pepealessio/self-balancing-robot-stm32/README.md

# Self Balancing Robot STM32

A demostration video can be watched at https://youtu.be/qOr8XTu--TQ.

The documentation can be readed at .\doc\documentation_v1.0.

The esp32 code is in .\ESP32_code

The STM32 code is in .\STM32_code

The desktop application is in .\Desktop_Controller
