pepealessio/self-balancing-robot-stm32/Schemes/control scheme.jpg

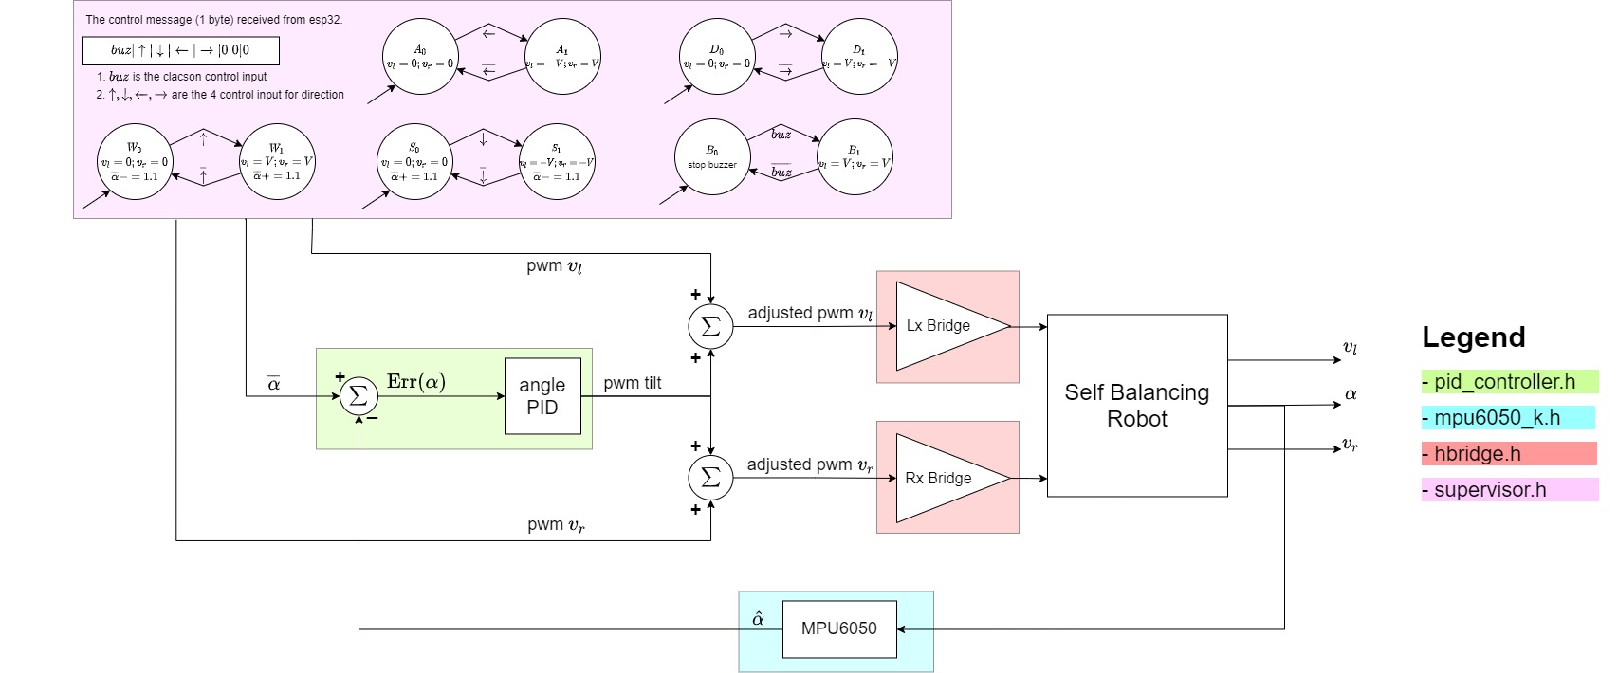
Schemes/control scheme.jpg
