pepealessio/self-balancing-robot-stm32/Schemes/SBR model.jpg

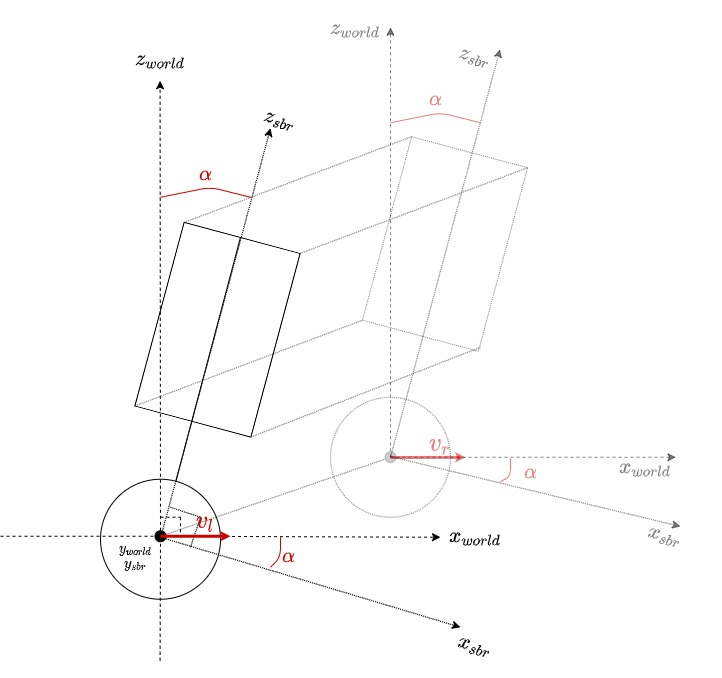
Schemes/SBR model.jpg
