pepealessio/self-balancing-robot-stm32/(list of files, drawings)

Other design files:
Schemes/sbr_v1.0.fzz
