pepealessio/self-balancing-robot-stm32/STM32_code/mcu6050_angle/Core/Src/main.c

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
/* Includes ------------------------------------------------------------------*/
#include "main.h"
#include "i2c.h"
#include "tim.h"
#include "usart.h"
#include "gpio.h"

/* USER CODE BEGIN Includes */
#include <stdlib.h>
#include <string.h>
#include <math.h>

#include "led.h"
#include "mpu6050_k.h"
#include "pid_controller.h"
#include "supervisor.h"
#include "hbridge.h"

/* USER CODE END Includes */

/* USER CODE BEGIN PD */

// Equilibrium PID parameters
#define KP_ANGLE 		(123)
#define KI_ANGLE		(78)
#define KD_ANGLE 		(50)

#define DT 				(15)

// Uncomment if you want use UART2 TX pin (same on USB, speed 115200) to read
// actual angle and cycle time.
//#define PRINT_DEBUG

/* USER CODE END PD */


/* USER CODE BEGIN PV */

#if defined (PRINT_DEBUG)
// Buffer for debugging print
char buffer[10];
#endif

uint32_t tick;

/* USER CODE END PV */

void SystemClock_Config(void);
/* USER CODE BEGIN PFP */

void Balancing_Error_Handler(void);
void print_on_UART(void);
void MPU_Error_Handler(void);

/* USER CODE END PFP */

/**
  * @brief  The application entry point.
  * @retval int
  */
int main(void)
{
  /* MCU Configuration--------------------------------------------------------*/

  /* Reset of all peripherals, Initializes the Flash interface and the Systick. */
  HAL_Init();

  /* Configure the system clock */
  SystemClock_Config();

  /* Initialize all configured peripherals */
  MX_GPIO_Init();
  MX_I2C1_Init();
  MX_USART2_UART_Init();
  MX_TIM1_Init();
  MX_TIM2_Init();
  MX_TIM3_Init();
  MX_TIM10_Init();
  MX_USART1_UART_Init();
  /* USER CODE BEGIN 2 */

  // Error led start
  Led__init(&hled0, GPIOA, GPIO_PIN_5);

  // Start motor controller
  hbridge__init(&hhbridge, &htim1);

  // Start MPU device
  if (MPU6050__Init(&hmpu, &hi2c1))
  {
	  MPU_Error_Handler();
  }

  // Start supervisor
  FSM__init(&hfsm);
  hfsm_buffer = 0x00;
  HAL_UART_Receive_IT(&huart1, &hfsm_buffer, 1);

  // Start pid
  pid__init(&hangle_pid, KP_ANGLE, KI_ANGLE, KD_ANGLE, FSM__ANGLE_OFFSET);

  /* USER CODE END 2 */

  /* Infinite loop */
  /* USER CODE BEGIN WHILE */
  while (1)
  {
    /* USER CODE END WHILE */

    /* USER CODE BEGIN 3 */

	tick = HAL_GetTick();

	/* ---------------------------------- READ INPUT ---------------------------------- */
	// Read the tilt angle.
	if (MPU6050__Read_All(&hmpu))
	{
		MPU_Error_Handler();
	}

	// Check for SBR is stand up. If it fallen stop the motor and the interrupt and attemps
	// for a reboot.
	if (fabs(hmpu.KalmanAngleY) > 60)
	{
		Balancing_Error_Handler();
	}

	/* ---------------------------------- EVALUATE OUTPUT ---------------------------------- */
	// Evaluate offset and target using the control byte received from esp32.
	FSM__update(&hfsm);

	// Use pid to evaluate the actual needed motor power.
	int64_t tilt_pwm = pid__evaluate_output(&hangle_pid, (int)(hmpu.KalmanAngleY * 100));

	/* ---------------------------------- WRITE OUTPUT ---------------------------------- */
	// Now control the motor with the previous calculation.
	hbridge__set_motor(&hhbridge, tilt_pwm + hfsm.left_target, tilt_pwm + hfsm.right_target);

#if defined (PRINT_DEBUG)
	print_on_UART();
#endif

	HAL_Delay(DT - (HAL_GetTick() - tick));
  }
  /* USER CODE END 3 */
}

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
/* USER CODE BEGIN 4 */

void Balancing_Error_Handler(void)
{
	// Disable control message IRQ
	HAL_NVIC_DisableIRQ(USART1_IRQn);

	// Stop motor
	hbridge__set_motor(&hhbridge, 0, 0);

	// Blink led
	TIM10->PSC = 11999;
	TIM10->ARR = 6999;
	HAL_TIM_Base_Start_IT(&htim10);

	// Wait for reset
	while (1)
	{

	}
}

void MPU_Error_Handler(void)
{
	// Disable control message IRQ
	HAL_NVIC_DisableIRQ(USART1_IRQn);

	// Stop motor
	hbridge__set_motor(&hhbridge, 0, 0);

	// Blink led
	TIM10->PSC = 11999;
	TIM10->ARR = 3749;
	HAL_TIM_Base_Start_IT(&htim10);

	// Wait for reset
	while (1)
	{

	}
}

#if defined (PRINT_DEBUG)
void print_on_UART(void)
{
	HAL_UART_Transmit(&huart2, (uint8_t *) "x: ", 3, 0xFFFF);
	gcvt(hmpu.KalmanAngleY, 6, buffer);
	strcat(buffer, "\r\n\0\0\0\0\0\0\0\0\0\0\0\0\0\0\0\0\0\0\0\0\0\0\0");
	HAL_UART_Transmit(&huart2, (uint8_t *) buffer, 10, 0xFFFF);

	HAL_UART_Transmit(&huart2, (uint8_t *) "y: ", 3, 0xFFFF);
	gcvt(hmpu.KalmanAngleY, 6, buffer);
	strcat(buffer, "\r\n\0\0\0\0\0\0\0\0\0\0\0\0\0\0\0\0\0\0\0\0\0\0\0");
	HAL_UART_Transmit(&huart2, (uint8_t *) buffer, 10, 0xFFFF);

	HAL_UART_Transmit(&huart2, (uint8_t *) "el: ", 4, 0xFFFF);
	itoa((int) hencoderl.cnt, buffer, 10);
	strcat(buffer, "\r\n\0\0\0\0\0\0\0\0\0\0\0\0\0\0\0\0\0\0\0\0\0\0\0");
	HAL_UART_Transmit(&huart2, (uint8_t *) buffer, 10, 0xFFFF);

	HAL_UART_Transmit(&huart2, (uint8_t *) "er: ", 4, 0xFFFF);
	itoa((int) hencoderr.cnt, buffer, 10);
	strcat(buffer, "\r\n\0\0\0\0\0\0\0\0\0\0\0\0\0\0\0\0\0\0\0\0\0\0\0");
	HAL_UART_Transmit(&huart2, (uint8_t *) buffer, 10, 0xFFFF);

	HAL_UART_Transmit(&huart2, (uint8_t *) "c.b. : ", 5, 0xFFFF);
	itoa(hfsm.current_control_message, buffer, 10);
	strcat(buffer, "\r\n\0\0\0\0\0\0\0\0\0\0\0\0\0\0\0\0\0\0\0\0\0\0\0");
	HAL_UART_Transmit(&huart2, (uint8_t *) buffer, 10, 0xFFFF);

	HAL_UART_Transmit(&huart2, (uint8_t *) "el.t: ", 6, 0xFFFF);
	itoa(HAL_GetTick() - tick, buffer, 10);
	strcat(buffer, "\r\n\0\0\0\0\0\0\0\0\0\0\0\0\0\0\0\0\0\0\0\0\0\0\0");
	HAL_UART_Transmit(&huart2, (uint8_t *) buffer, 10, 0xFFFF);
}
#endif

/* USER CODE END 4 */
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
