pepealessio/self-balancing-robot-stm32/STM32_code/mcu6050_angle/mcu6050_angle.ioc

Mcu.UserName=STM32F401RETx
PC0.Signal=GPIO_Input
PA0-WKUP.Signal=S_TIM2_CH1_ETR
PA9.Signal=S_TIM1_CH2
PB6.Signal=USART1_TX
PA1.Signal=S_TIM2_CH2
PA5.Signal=GPIO_Output
PB7.Signal=USART1_RX
PA8.Signal=S_TIM1_CH1
PA2.Signal=USART2_TX
PB9.Signal=I2C1_SDA
PA6.Signal=S_TIM3_CH1
PA11.Signal=S_TIM1_CH4
PA10.Signal=S_TIM1_CH3
PB8.Signal=I2C1_SCL
PA3.Signal=USART2_RX
PA7.Signal=S_TIM3_CH2
