pepealessio/self-balancing-robot-stm32/(commit log)

2021-06-28 all file add
    [sbr_v1.0.fzz]
2021-06-29 moving with inclination
    [sbr_v1.0.fzz]
2021-06-29 updated hardware connection and pc controller. Fixed esp32 reboot. Fixed trash value in the control byte
    [sbr_v1.0.fzz]
2021-06-29 fix old trash value in disconnection
    [SBL_BT_receiver.ino, pid_controller.c, supervisor.h]
2021-06-29 Buttons upRight, upLeft, downRight and downLeft added
2021-06-30 minor fix. good parameter with -13 pieces
    [main.c, mcu6050_angle.ioc, mpu6050_k.c, mpu6050_k.h, pid_controller.h, supervisor.c, supervisor.h]
2021-06-30 interface button responsive hold and press fixed
2021-06-30 diagonal buttons deleted
2021-06-30 scheme update
    [sbr_v1.0.fzz]
2021-07-03 kd pid fix
